noqworks/sos/hardware/step/case-assembly.step

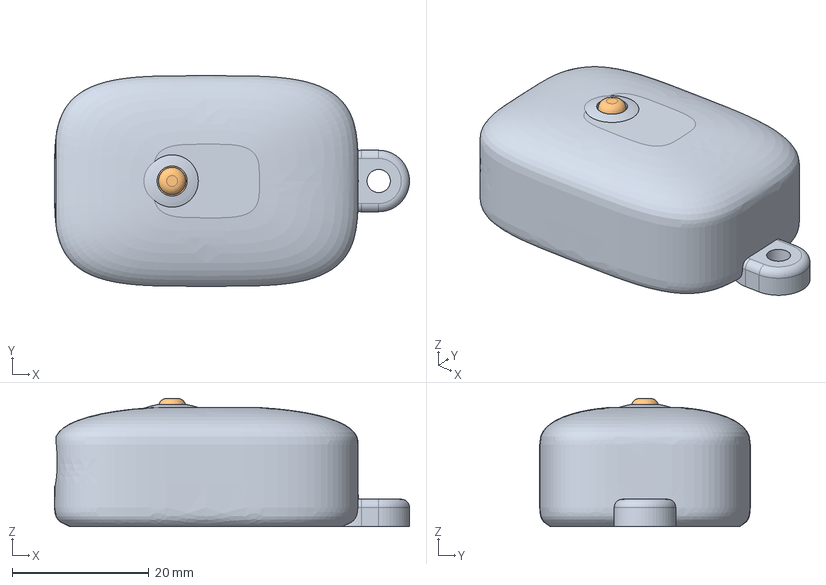
[picture p1: CAD file, 2026-11-07]
hardware/step/case-assembly.step
51.9 x 30.8 x 18.7 mm
