noqworks/sos/hardware/stl/case-lid.stl

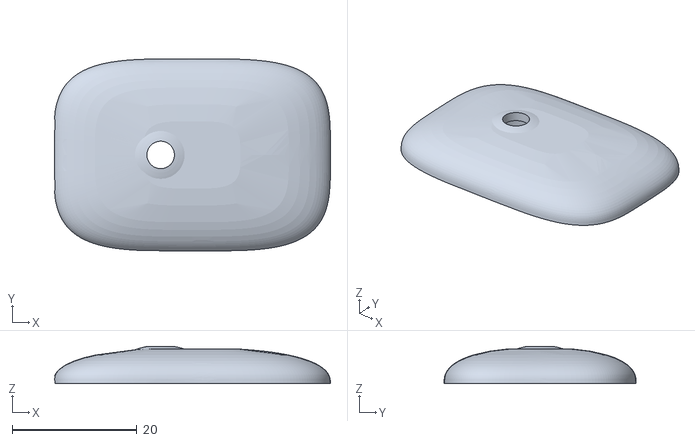
[picture p2: CAD file, 2026-11-07]
hardware/stl/case-lid.stl
44.2 x 30.8 x 5.93
