noqworks/sos/hardware/stl/case-base.stl

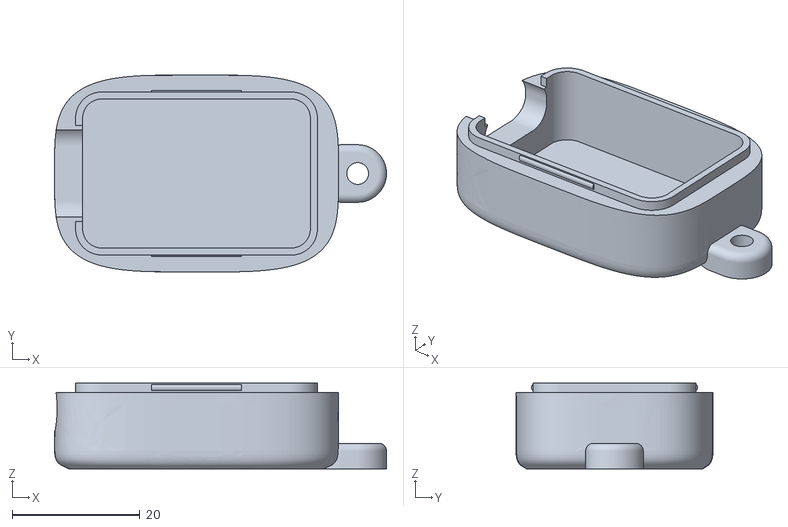
[picture p3: CAD file, 2026-11-07]
hardware/stl/case-base.stl
51.9 x 30.8 x 13.4
