noqworks/sos/hardware/stl/case-pin.stl

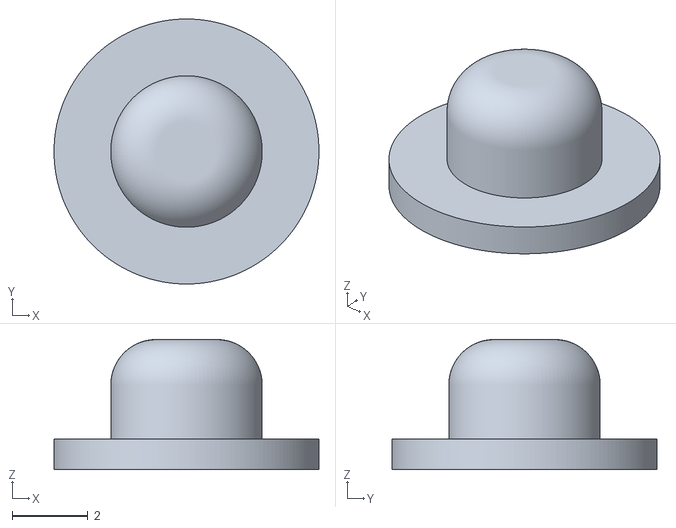
[picture p4: CAD file, 2026-11-07]
hardware/stl/case-pin.stl
7.00 x 7.00 x 3.43
