noqworks/sos/(commit log)

2026-11-05 NOQ SOS 0.2.0: Telegram commands
    /status, /battery, /help and /durum, /pil, /yardim in a private chat or a family group, answered as a reply in the language of the command; only chats on the list get an answer. Asleep the pendant checks for commands every hour by default (15, 30 minutes, 3 hours or only on a press and the check-in). Settings from 0.1.0 are kept.
2026-11-07 Case: three-part PETG enclosure (base, snap-fit lid, button pin)
    STL and STEP files plus the parametric CadQuery source (hardware/cad/sos_case.py). Prints without supports.
    [case-assembly.step, case-base.stl, case-lid.stl, case-pin.stl]
2026-11-11 NOQ SOS 0.3.0: case, battery log, /wake, discovery mode
    Battery log on the pendant's page, in /battery and in the check-in; impossible readings are shown as such instead of a made-up percentage.
    /wake and /uyan keep a wrapped-up pendant awake for 10 minutes. Discovery mode maps the Wi-Fi signal around the house without sending alerts.
    Turkish wiring diagram; release notes and changelog from releases.json.
